grillbaer/esp32-geiger-counter/hardware/kicad/project/geiger/geiger.kicad_pcb

## KiCad design botonera-central/botonera-central.sch

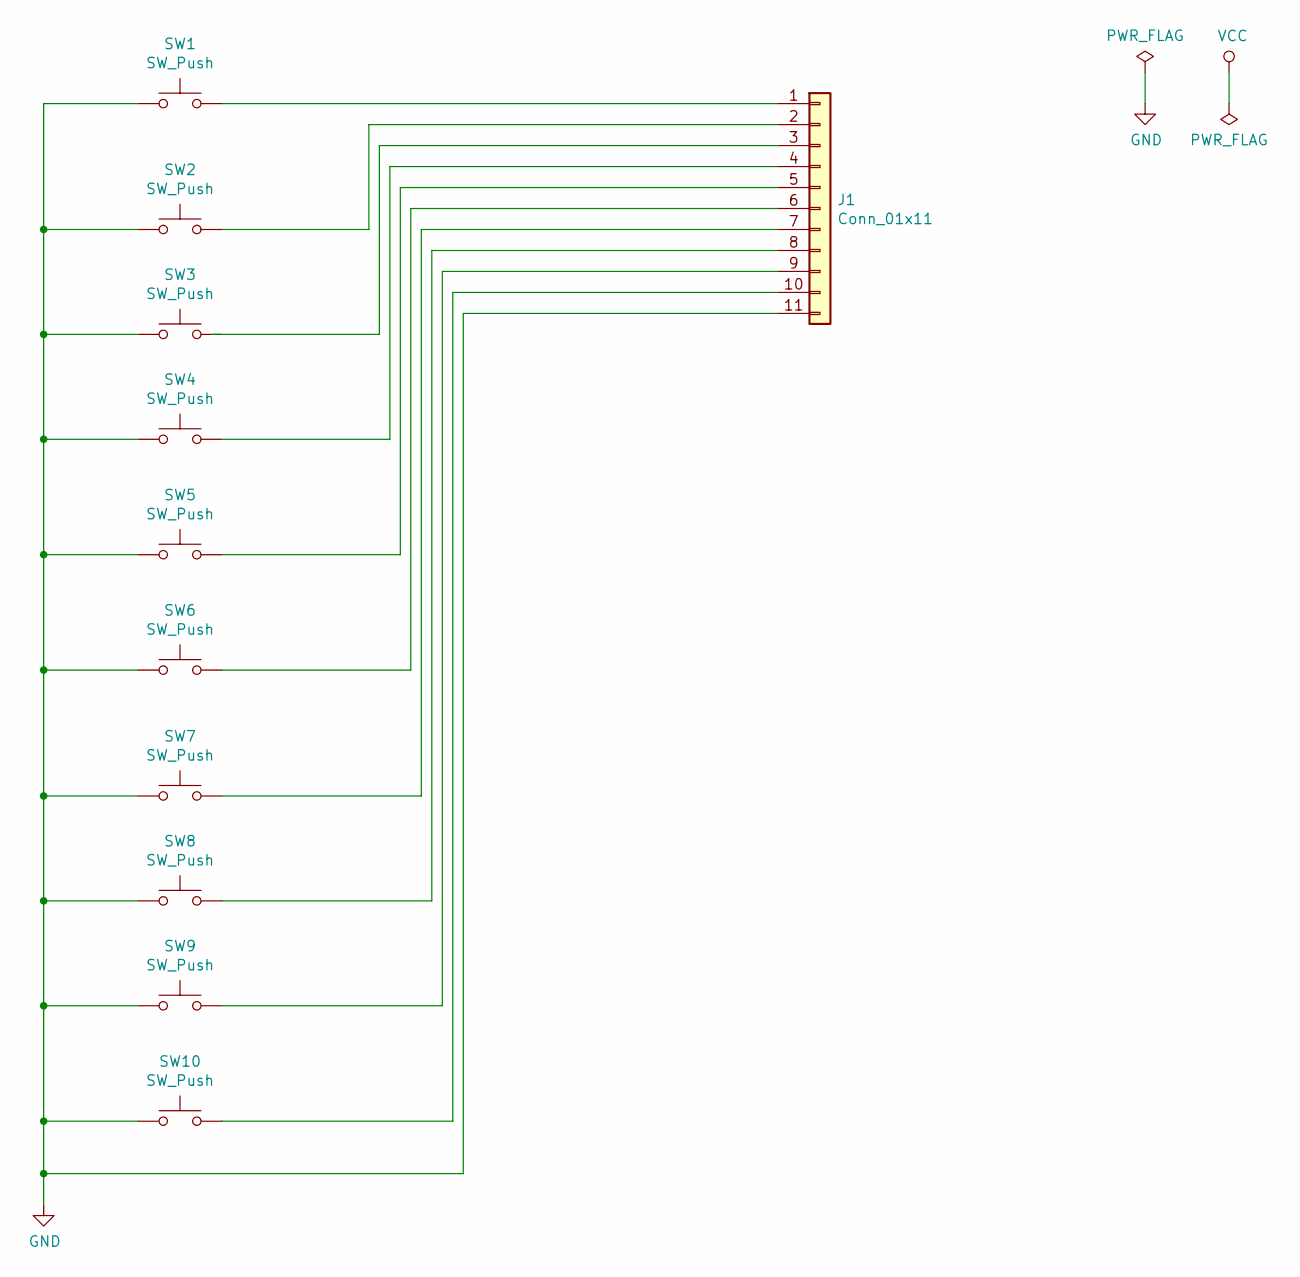
[picture p7: schematic botonera-central.sch]

Parts:
J1: Conn_01x11
SW1, SW2, SW3, SW4, SW5, SW6, SW7, SW8, SW9, SW10: SW_Push

Connections:
GND: J1.11, SW1.1, SW2.1, SW3.1, SW4.1, SW5.1, SW6.1, SW7.1, SW8.1, SW9.1, SW10.1
unnamed: J1.1, SW1.2
unnamed: J1.2, SW2.2
unnamed: J1.4, SW4.2
unnamed: J1.5, SW5.2
unnamed: J1.6, SW6.2
unnamed: J1.7, SW7.2
unnamed: J1.8, SW8.2
unnamed: J1.9, SW9.2
unnamed: J1.10, SW10.2
