grillbaer/esp32-geiger-counter/(threads)

Thread 1 (2020-01-14):

[question] compatability

Tom-Neverwinter, 2020-01-14:
Is this code compatible with the Geiger counter kits?

For instance can this be used with this setup?
https://www.youtube.com/watch?v=K28Az3-gV7E&feature=youtu.be

grillbaer, 2020-01-14:
I also own that (or a similar?) kit. My kit outputs 3.3 V low pulses of about 300 µs length at the VIN pin (using 5 V power supply):
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

3.3 V output is great, since it might be used directly as input for the ESP32. Please make sure that your kit also outputs not more that 3.3 V or you might blow your GPIO!

My current code counts high pulses on GPIO 18, not low pulses.

However, in WiFi mode (GPIO 4 low), the code simply counts rising edges using interrupts. So it should still work out of the box since each pulse always has a rising and a falling edge.

In low-power mode (GPIO 4 high), it uses light sleep to wait for a pulse input change. This will not work directly with the kit, because it expects a high level after the first wake-up and a low level after the second wake-up. You could change the expected level in `main.cpp` `takeSampleLowPower()`. The pulse length of 300 µs should probably be long enough for the light-sleep wake-up, but I'm not absolutely sure.

The factor `STS6_CPM_PER_USPH` used in `main.cpp` to convert count-per-minute to the estimated micro-sievert-per-hour must be replaced with a lower value for that much more insensitive tube.

Tom-Neverwinter, 2020-01-14:
Thank you for the information :)

Closed 2021-04-06.

Thread 3 (2021-03-27):

Diode and inductor.

miguerman, 2021-03-27:
Hello. I am looking for the 200v and 500mw zener diodes of the BZX79C200 model that appears in the diagram, but it is difficult for me to get it, can you recommend another 200v zener model, the 10mH inductor cannot be found either. Thanks

grillbaer, 2021-03-28:
Hi, you may use any series of zener diodes that add up to a voltage drop of about 400 V, e.g. 4 times 100 V in series. There's no need for a special type. Their max power does not matter, since there will be almost no current through it. So simply take the smallest ones. These z-diodes' task is to cut of the generator when their total voltage drop (=the target voltage) is exceeded, which works by a small current starting to flow through them then.

Both z-diodes and fixed inductors should be available from almost any electronics parts retailer.

My favorite retailer in Germany has e.g. this inductor https://www.reichelt.de/festinduktivitaet-axial-hm50-ferrit-10-mh-bi-hm50-103klf-p245509.html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 and these z diodes https://www.reichelt.de/zenerdiode-200-v-2-w-do-41-zy-200-dio-p219675.html?&trstct=pol_2&nbc=1.
I don't know in which part of the world you live, so perhaps you better look into the products of a local retailer, maybe rs electronics or digikey are there.

Closed 2021-04-06.

Thread 4 (2021-04-09):

WiFi connect fails permanently after a few weeks or months of operation

grillbaer, 2021-04-09:
Every few months the WiFi connection stops working and then fails permanently. Reset or power off do not help. Only erasing the ESP32 flash with ESP32 tools plus re-flashing the software makes it work again.

Connection status is WL_DISCONNECTED 6.

=> Check which information ESP32 FW, WiFiClient and WiFiClientSecure store in flash. Try to reset it automatically upon connection failures.

grillbaer, 2021-04-09:
Default setting is to store some configs in flash `esp_wifi_set_storage(WIFI_STORAGE_FLASH)`.
Maybe connected issue espressif/esp32-wifi-lib#6.

grillbaer, 2021-04-09:
Now set `WiFi.persistent(false)` before connect which leads to `esp_wifi_set_storage(WIFI_STORAGE_RAM)`. Hope this solves the problem permanently ... let's observe it.

Closed 2021-04-09.

Thread 5 (2023-08-31):

What should I do if I want to use Arduino to compile?

zhouxule, 2023-08-31:
Hi,
I only have VS (not VS code) and Arduino on my PC. How can I use Arduino to compile the program?

Thanks and best regards. :)

grillbaer, 2023-09-05:
Hi @zhouxule,

I recommend using VS Code and its PlatformIO plug-in. VS Code can be installed in parallel to Visual Studio without any problems, it is completely free and many developers really like it. Note that Visual Studio and VS Code are two completely independent IDEs with somehow similar names.

If you still want to try it with the Arduino IDE, I guess you need to install its ESP32 add-on and the libraries listed in this project's file `platformio.ini` (U8g2, 256dpi) by hand and copy the source files from the projects `src` folder to the IDE. Maybe it also complains about some `#include` statements in the project source files and you have to remove them or find the right way of handling. Since I have no real experience with the Arduino IDE, this is only guessing.

Best regards,
Holger

Thread 8 (2025-09-15):

STS-5

sledzik1984, 2025-09-15:
Can I use STS-5 sensor - not STS-6?
I have one in one of my "weird things" boxes ;)

grillbaer, 2025-09-15:
Sorry, I don't know. Maybe you can find some information or datasheet for it on the internet. If it works with a roughly similar voltage around 400 V it is likely to work. It the required voltage is lower, you might adjust the zener diodes D2+D3 in the circuit to get a lower voltage. Adjusting the voltage up is likely to blow the transistor Q2. You'll have to try it out.

You will also need to adjust the calibration constant STS6_CPM_PER_USPH used in main.cpp. A different tube will deliver a different CPM rate at the same radiation level. A better constant might be in the datasheet or you can compare the known background radiation level from an official measurement station with your own measurement.

Closed 2025-09-15.
