grillbaer/esp32-geiger-counter/(commit log)

2019-04-14 Better WiFi connect and reconnect, online WiFi<->low power switching
2019-04-18 adjusted tube sensitivity 875 -> 825 cpm/(µS/h)
2019-10-19 added pulse forming schematic and signals
2019-10-19 updated schematic
2020-01-05 fixed encoding problem of char 'micro'
    [display.cpp]
2020-01-05 disconnect from WiFi on any error to force retry
    [ingest.cpp]
2020-01-05 changed serial baud to ESP32 default 115200
2020-11-15 trying to fix mqtt stops to work after a few hours
    [ingest.cpp, ingest.h, main.cpp]
2020-12-10 trying to fix travis ci build
    [credentials.cpp]
2021-01-29 added re-engineered DRAFT KiCad schematics
    [geiger.kicad_pcb, geiger.sch]
2021-01-30 checked and corrected KiCad schematic
    [geiger.sch]
2021-01-30 updated readme for schematic
2021-03-07 changed pins for EZSCB ESP32
    [geiger.sch]
2021-03-07 blinky LED now on GPIO 18
2021-04-09 Set WiFi persistent false to fix connect error #4
    [ingest.cpp]
